spacelab-ufsc/eps-re/(threads)

Thread 2 (2023-07-19):

Hardware: Wrong nets' names

joaoclaudioeb, 2023-07-19:
In file MPPT_Battery_Charger.kicad_sch, the nets VBC_N and VBC_IN should be the same:

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

Closed 2023-07-21.

Thread 3 (2023-07-19):

Hardware: Wrong configuration for signals BC_A_EN and BC_B_EN

joaoclaudioeb, 2023-07-19:
In file MPPT_Battery_Charger.kicad_sch, the signal BC_A_EN should be high as default (pull-down configuration) and BC_B_EN low as default (pull-up configuration):

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

Closed 2023-07-21.

Thread 4 (2023-07-19):

Hardware: Wrong connection of U28's pin

joaoclaudioeb, 2023-07-19:
In file MPPT_Battery_Charger.kicad_sch, TERM_EN of U28 should be connected to VREF, too:

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

Closed 2023-07-21.

Thread 7 (2023-07-21):

Hardware: Add the thermistor to the schematic

joaoclaudioeb, 2023-07-21:
The BQ24650RVAT needs a thermistor to properly adjust the V<sub>MP</sub> of the solar panel when the temperature varies. It is necessary to calculate its value and define its position in the PCB.

joaoclaudioeb, 2023-10-17:
Update: We won't be using a thermistor for now. We're going to use a fixed value of resistors in the "resistive network", on the MPPSET pin. Because we still have to consider how, on the mission, we're going to add this thermistor to the satellite. So, for now, the "resistive network" should be calculated for a fixed value of 25°C.

rebeccaquintino, 2023-10-19:
Update: We used the texas instruments spreadsheet to calculate the resistor network and concluded that 270k ohm is enough to evaluate the tests.

Closed 2023-10-20.

Thread 8 (2023-08-25):

Hardware: Adjust the proximity of output and input capacitors, inductors and shunt resistors

comesanha, 2023-08-25:
Considering the demonstration circuit 1640A (https://www.analog.com/en/products/ltc3833.html#product-overview), try to keep power train components inside a 4,825 cm² area: C<sub>in</sub>, C<sub>out</sub>, inductor and MOSFETs.

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

Closed 2023-09-12.

Thread 10 (2023-08-26):

Hardware: Update the position of some components

comesanha, 2023-08-26:
From LTC3833

- Place the ceramic Cvcc capacitor (C110/C111/C22/C23 in circuit) as close as possible to INTVCC and PGND pins.

- The CB capacitor (C20/C21/C108/C109 in circuit) should be as close as possible to BOOST and SW pins.

- Place small-signal components as close to their respective pins as possible. Give priority to VOSNS+/VOSNS–, SENSE+/SENSE–, ITH, RT and VRNG pins.

- Use sufficient isolation when routing a clock signal into MODE/PLLIN pin so that the clock does not couple into sensitive small-signal pins.

- Filter the Vin input to the LTC3833 with a simple RC filter close to the pin. The RC filter should be referenced to signal ground.

rebeccaquintino, 2023-09-11:
- [ ] Place the ceramic Cvcc capacitor (C110/C111/C22/C23 in circuit) as close as possible to INTVCC and PGND pins.
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

- [ ] The CB capacitor (C20/C21/C108/C109 in circuit) should be as close as possible to BOOST and SW pins.
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

- [ ] Place small-signal components as close to their respective pins as possible. Give priority to VOSNS+/VOSNS–, SENSE+/SENSE–, ITH, RT and VRNG pins.
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

- [ ] Use sufficient isolation when routing a clock signal into MODE/PLLIN pin so that the clock does not couple into sensitive small-signal pins.
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

Closed 2023-09-11.

Thread 9 (2023-08-26):

Hardware: Add Kelvin connection for shunt resistor and update some components' proximity

comesanha, 2023-08-26:
From LTC3833 Datasheet:

- Place de sense resistor (R78/R79/R48/R47 in circuit) close to the inductor (L1/L2/L4/L8 - in circuit) on the output side.

- Use a Kelvin (4-wire) connection across the sense resistor (R78/R79/R48/R47 in circuit) and route the traces together as a differential pair. RC filter the differential sense signal close to SENSE+/SENSE– pins, placing the filter capacitor (C18-R43-R44/C19-R45-R46/C106-R64-R65/C107-R62-R61 in circuit) as close as possible to the pins.

- Place the resistive feedback divider RFB1/2 (R53-R54/R55-R56/R49-R50/R51-R52/R80-R140/R81-R142) as close as possible to VOSNS+/VOSNS– pins and route the remote output and ground traces together as a differential pair and terminate as close to the regulation point as possible. (preferably Kelvin connect across the capacitor at the remote output point).

vitoria-b, 2023-09-06:
From the datasheet: "_Place the ceramic CVCC capacitor as close as possible to INTVCC and PGND pins. Likewise, the CB capacitor should be as close as possible to BOOST and SW pins. These capacitors provide the gate charging currents for the power MOSFETs_" should our Cvcc: C110/C111/C22/C23 be closer to 11 and 12 pins or it is in an okay distance?
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

rebeccaquintino, 2023-09-11:
- [X] Place de sense resistor (R78/R79/R48/R47 in circuit) close to the inductor (L1/L2/L4/L8 - in circuit) on the output side.
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

- [X] Use a Kelvin (4-wire) connection across the sense resistor (R78/R79/R48/R47 in circuit) and route the traces together as a differential pair. RC filter the differential sense signal close to SENSE+/SENSE– pins, placing the filter capacitor (C18-R43-R44/C19-R45-R46/C106-R64-R65/C107-R62-R61 in circuit) as close as possible to the pins.
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

- [X] Place the resistive feedback divider RFB1/2 (R53-R54/R55-R56/R49-R50/R51-R52/R80-R140/R81-R142) as close as possible to VOSNS+/VOSNS– pins and route the remote output and ground traces together as a differential pair and terminate as close to the regulation point as possible. (preferably Kelvin connect across the capacitor at the remote output point). Done!
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

Closed 2023-09-11.

Thread 11 (2023-09-06):

Hardware: Divide the GND into signal and power GND's

comesanha, 2023-09-06:
Talking together with Victor Noster, we defined the signal GND as the one represented with a "triangle", while the power GND is represented with the "dashes" in the figure below.

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

rebeccaquintino, 2023-09-11:
The "triangle" was not placed for the resistive divider and the 4.7uF capacitor as shown in the datasheet image.
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

Closed 2023-09-14.

Thread 12 (2023-09-06):

Hardware: update some components' proximity

comesanha, 2023-09-06:
You should try to:

- Move Q5 closer to the IC.
- Move C92 and C93 down, closer to the IC, without moving them away from the MOSFETs.
- Move C81 to the right, closer to the IC.
- Move C84 to the left, closer to the IC.
- Move C98 and C90 to the left and down, closer to the IC, without moving them away from the R<sub>sense</sub>.

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

rebeccaquintino, 2023-09-11:
Move Q5 closer to the IC done!
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

Move C92 and C93 down, closer to the IC without moving them away from the MOSFETs done!
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

Move C81 to the right, closer to the IC done!
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

Move C84 to the left and down, closer to the IC done!
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

Move C98 and C90 to the left and down, closer to the IC, without moving them away from the Rsense.
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
C90 could be closer to the IC
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

Closed 2023-09-14.

Thread 15 (2023-09-06):

Hardware: Update components location

vitoria-b, 2023-09-06:
According to datasheet: "_Filter the VIN input to the LTC3833 with a simple RC filter close to the pin. The RC filter should be referenced to signal ground_".

In our layout, R31/C10, R32/C11, R96/C99 and R95/C99 are far from pin number 10 (their respective Vin). It would be better to put closer. Below are disposed referenced images:

**- Original typical application:**
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

**- In our schematics:**
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

**- In layout:**
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

rebeccaquintino, 2023-09-11:
Feito
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

Closed 2023-09-11.

Thread 16 (2023-09-18):

Hardware: Check the mounting holes position in the PCB

joaoclaudioeb, 2023-09-18:
Check if the mounting holes are positioned correctly in the board.

ramonborba, 2023-11-01:
Mounting holes measurements:

---

Diagonal 1:

EPS 2.0:
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
RE2PS:
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

---

Diagonal 2:

EPS 2.0:
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
RE2PS:
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

---

Diagonal 3:

EPS 2.0:
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
RE2PS:
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

---

Diagonal 4:

EPS 2.0:
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
RE2PS:
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

---

Hole outer radius:

EPS 2.0:
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
RE2PS:
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

---

Hole inner radius:

EPS 2.0:
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
RE2PS:
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

---

Side 1:

EPS 2.0:
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
RE2PS:
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

---

Side 2:

EPS 2.0:
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
RE2PS:
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

---

Side 3:

EPS 2.0:
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
RE2PS:
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

---

Side 4:

EPS 2.0:
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
RE2PS:
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

Thread 17 (2023-10-17):

Hardware: Check the blocking diodes

joaoclaudioeb, 2023-10-17:
Check that the blocking diodes added are suitable for testing at the moment. They won't necessarily be the final models, but it would be important to consider whether they would be sufficient for a 2U/3U CubeSat.

joaoclaudioeb, 2024-07-14:
Maybe it would be a good idea to use the same diodes used in the EPS2, which were also used in the EPS1, the SMD22WS-TP.

Thread 19 (2023-10-17):

Workflow: Check KiBot related files

joaoclaudioeb, 2023-10-17:
It seems that using multiple schematic files is becoming a problem for KiBot. It can't find all the schematic files and therefore doesn't execute the workflow correctly.

joaoclaudioeb, 2023-10-20:
For now, the problems were fixed. We suggest, for the next projects, to use the same project structure of the RE²PS.

joaoclaudioeb, 2023-10-20:
For now, the problems were fixed. We suggest, for the next projects, to use the same project structure of the RE²PS.

Closed 2023-10-20.

Thread 23 (2024-07-14):

Hardware: Add the "VBAT" net to the kill-switch circuits

joaoclaudioeb, 2024-07-14:
J9, J10, J18, and J17 should have connections to the battery for the circuit to be functional. In the initial models, some wires were soldered to these connectors, but this needs to be corrected for the next version.

Closed 2024-07-14.

Thread 24 (2024-07-14):

Hardware: Adjust the symbol of the tantalum capacitors

joaoclaudioeb, 2024-07-14:
These capacitors are reverse polarized. This was already fixed in the initial versions by re-soldering them, but it needs to be properly corrected for the next version.

Closed 2024-07-14.

Thread 25 (2024-07-14):

Hardware: Adjust the symbol of BAT54

joaoclaudioeb, 2024-07-14:
The pins used for the cathode and anode of the diode were 1 and 2, but they should be 1 and 3. This was already worked around for the test version, but it needs to be corrected for the next version of the board.

Closed 2024-07-14.

Thread 26 (2024-07-14):

Hardware: Adjust the value of the LTC3833's sense resistor

joaoclaudioeb, 2024-07-14:
The value seems to be wrong. A new value should be defined and used.
